joonastikkanen/esphome-nfc-components/hardware/vesimittari_v1_3/Havainne.FCStd

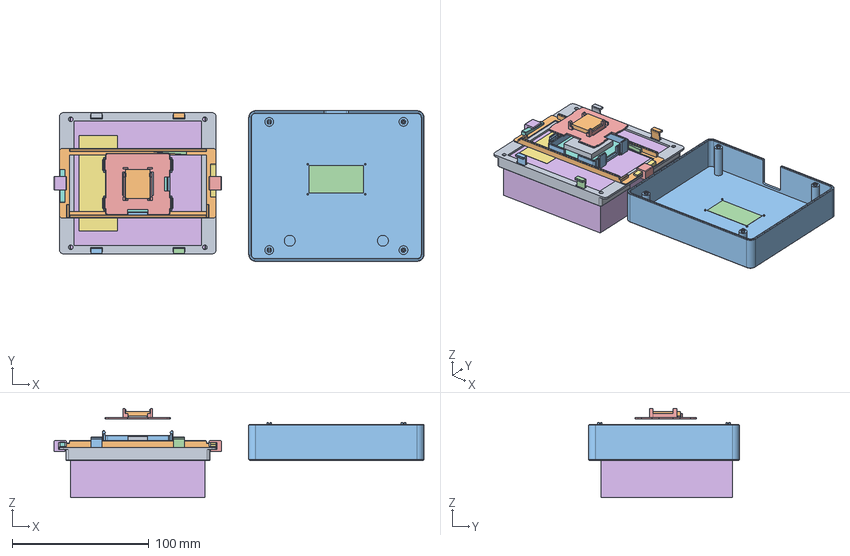
[picture p3: CAD file, 2026-11-05]
hardware/vesimittari_v1_3/Havainne.FCStd
270.2 x 110.0 x 65.0 mm
01 · Mittarin satula / sovitusrengas
02 · Y-liike ±16 mm / X-ohjain
03 · NFC-kortin liukukotelo / X ±20 mm
04 · X-säädön kitkakiila
05 · Y-säädön C-puristin, oikea
05b · Y-puristin, vasen
06 · Y-puristimen kiristyskiila, oikea
06b · Y-kiila, vasen
07 · Mittarikiinnityksen sovituskiila
072 · Sovituskiila
073 · Sovituskiila
074 · Sovituskiila
10 · NFC-kansi + ESP32-C3-pidike
Mittari 98 × 96 / näyttötaso +35 (yksinkertaistus)
Näyttö – sijainti vain havainnollinen
NFC PCB X42.6 × Y40.5 / paksuus oletus 1.6
NFC komponenttien tilavaraus, 6 mm oletus
ESP32-C3 17.8 × 21 × 3.5 – NFC-kannen päällä
Kansi_auki
WiFi_antenni
