joonastikkanen/esphome-nfc-components/hardware/vesimittari_v1_3/stl/01_Satula.stl

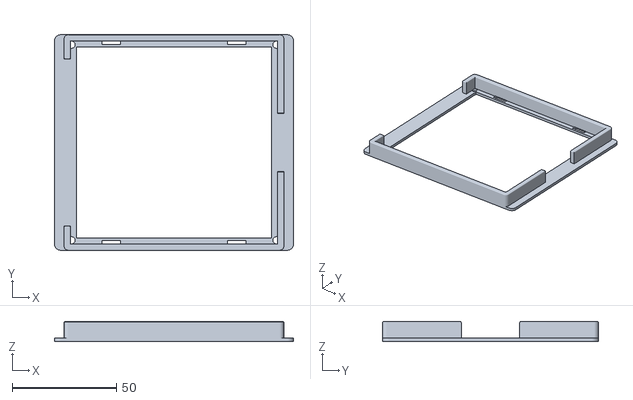
[picture p4: CAD file, 2026-11-05]
hardware/vesimittari_v1_3/stl/01_Satula.stl
114.4 x 103.2 x 9.60
