joonastikkanen/esphome-nfc-components/hardware/vesimittari_v1_3/stl/02_Poikittaiskelkka.stl

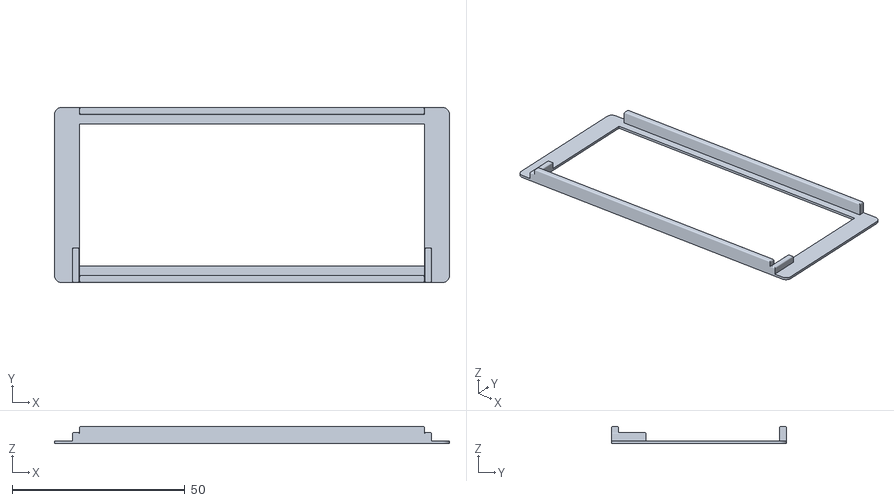
[picture p5: CAD file, 2026-11-05]
hardware/vesimittari_v1_3/stl/02_Poikittaiskelkka.stl
114.4 x 50.7 x 5.00
