joonastikkanen/esphome-nfc-components/hardware/vesimittari_v1_3/Vesimittari_NFC.step

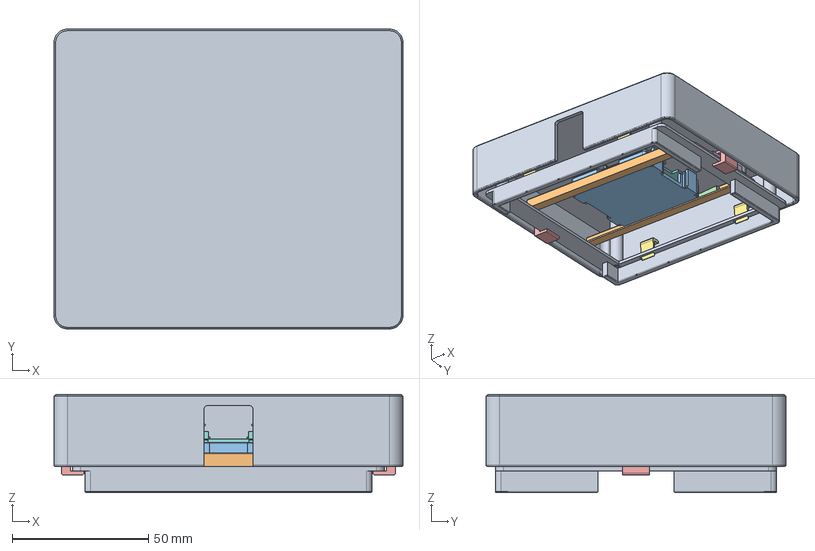
[picture p6: CAD file, 2026-11-05]
hardware/vesimittari_v1_3/Vesimittari_NFC.step
128.0 x 110.0 x 36.0 mm
