joonastikkanen/esphome-nfc-components/hardware/vesimittari_v1_3/stl/05_C_puristin.stl

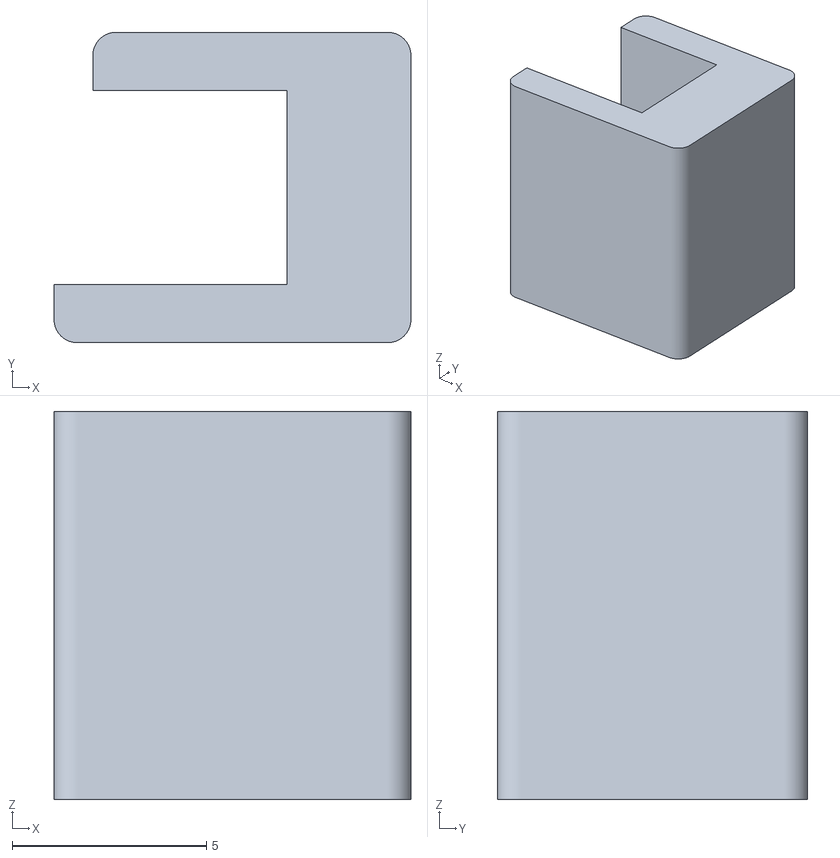
[picture p7: CAD file, 2026-11-05]
hardware/vesimittari_v1_3/stl/05_C_puristin.stl
9.20 x 8.00 x 10.0
