joonastikkanen/esphome-nfc-components/hardware/vesimittari_v1_3/Tulostusosat.FCStd

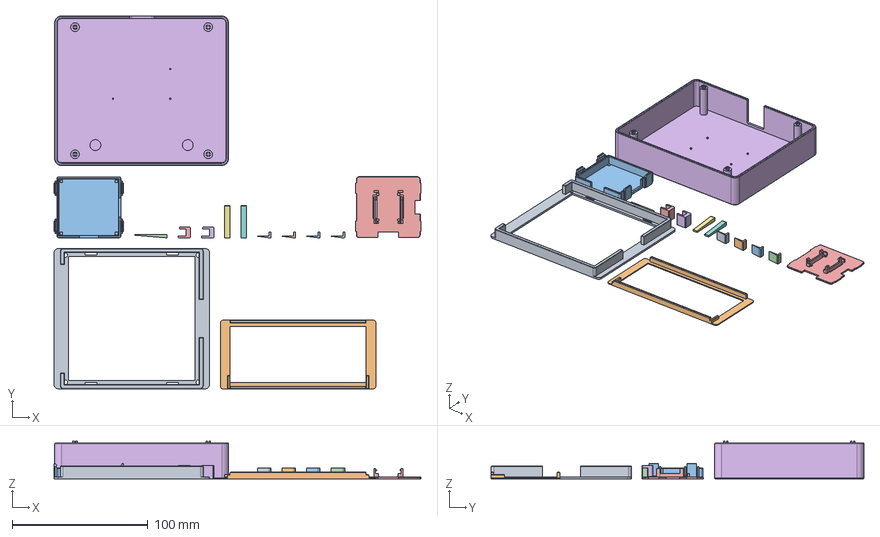
[picture p8: CAD file, 2026-11-05]
hardware/vesimittari_v1_3/Tulostusosat.FCStd
270.0 x 274.5 x 27.9 mm
01 · Mittarin satula / sovitusrengas / 1
02 · Y-liike ±16 mm / X-ohjain / 1
03 · NFC-kortin liukukotelo / X ±20 mm / 1
04 · X-säädön kitkakiila / 1
05 · Y-säädön C-puristin, oikea / 1
05 · Y-säädön C-puristin, oikea / 2
06 · Y-puristimen kiristyskiila, oikea / 1
06 · Y-puristimen kiristyskiila, oikea / 2
07 · Mittarikiinnityksen sovituskiila / 1
07 · Mittarikiinnityksen sovituskiila / 2
07 · Mittarikiinnityksen sovituskiila / 3
07 · Mittarikiinnityksen sovituskiila / 4
10 · NFC-kansi + ESP32-C3-pidike / 1
08 · Suojakansi / Wi-Fi-antenni / 1
