joonastikkanen/esphome-nfc-components/hardware/vesimittari_v1_3/stl/06_Y_kiila.stl

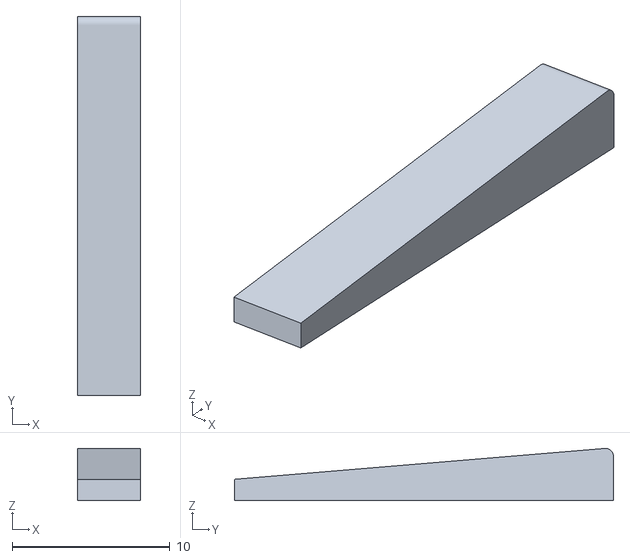
[picture p9: CAD file, 2026-11-05]
hardware/vesimittari_v1_3/stl/06_Y_kiila.stl
4.00 x 24.0 x 3.31
