joonastikkanen/esphome-nfc-components/hardware/vesimittari_v1_3/stl/03_NFC_kelkka.stl

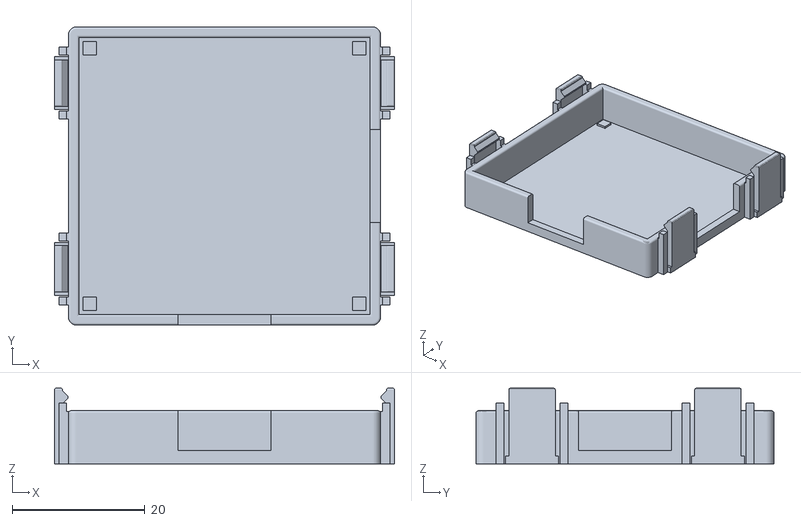
[picture p10: CAD file, 2026-11-05]
hardware/vesimittari_v1_3/stl/03_NFC_kelkka.stl
51.2 x 44.9 x 11.4
