joonastikkanen/esphome-nfc-components/hardware/vesimittari_v1_3/stl/08_Kansi.stl

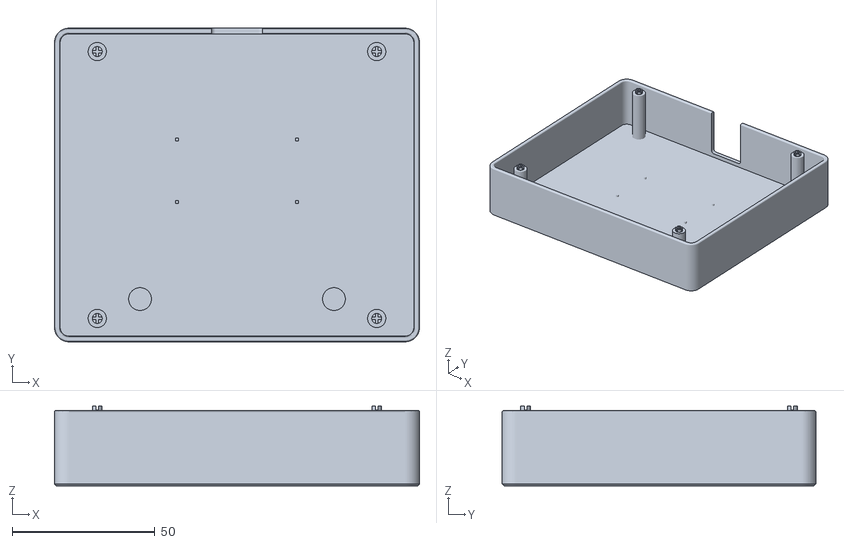
[picture p11: CAD file, 2026-11-05]
hardware/vesimittari_v1_3/stl/08_Kansi.stl
128.0 x 110.0 x 27.9
