joonastikkanen/esphome-nfc-components/hardware/vesimittari_v1_3/stl/04_X_kiila.stl

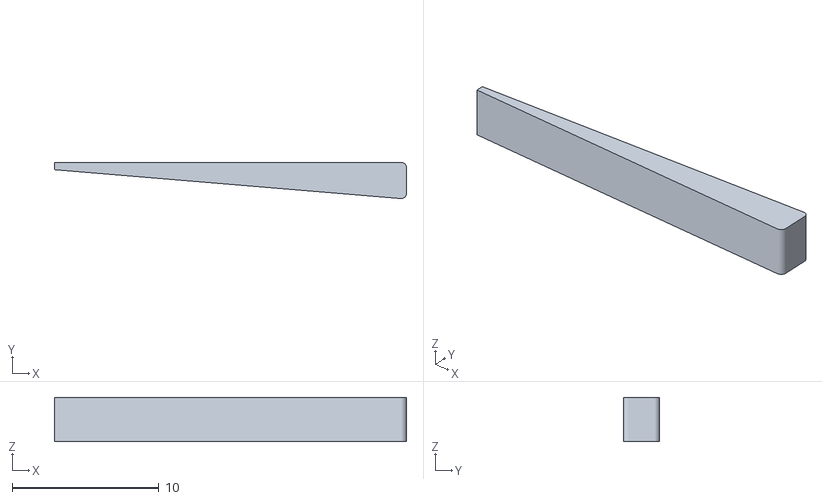
[picture p12: CAD file, 2026-11-05]
hardware/vesimittari_v1_3/stl/04_X_kiila.stl
24.0 x 2.47 x 3.00
