joonastikkanen/esphome-nfc-components/hardware/vesimittari_v1_3/stl/10_NFC_kansi_ESP_pidike.stl

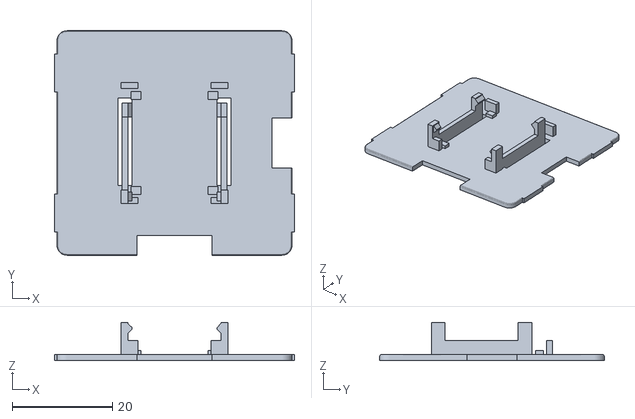
[picture p13: CAD file, 2026-11-05]
hardware/vesimittari_v1_3/stl/10_NFC_kansi_ESP_pidike.stl
48.0 x 44.9 x 7.60
