joonastikkanen/esphome-nfc-components/hardware/vesimittari_v1_3/stl/07_Sovituskiila.stl

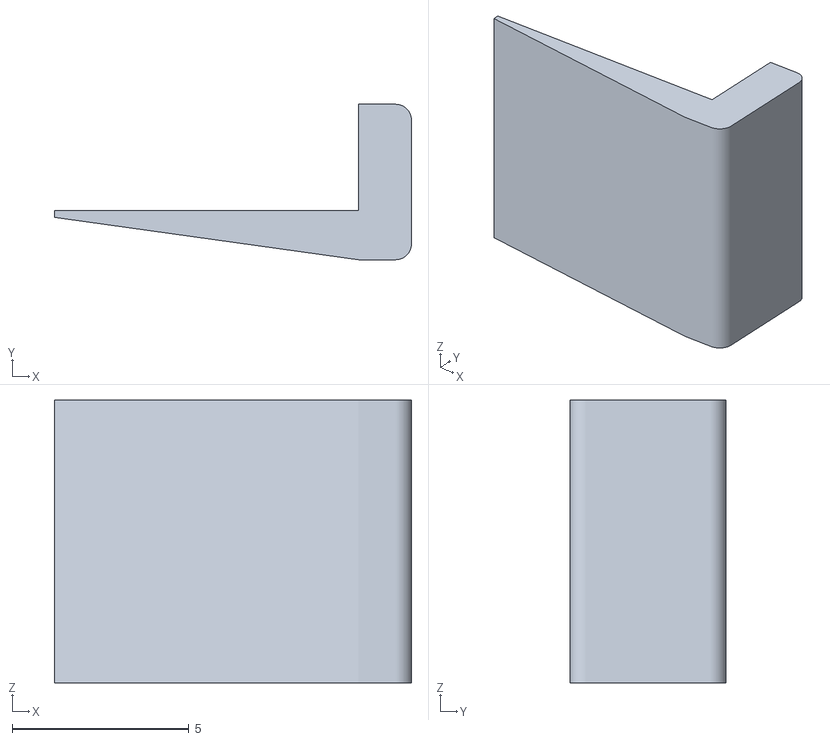
[picture p14: CAD file, 2026-11-05]
hardware/vesimittari_v1_3/stl/07_Sovituskiila.stl
10.1 x 4.40 x 8.00
