joonastikkanen/esphome-nfc-components/(list of files, cad)

Other CAD files:
hardware/vesimittari_v1_3/Vesimittari_NFC.FCStd
