joonastikkanen/esphome-nfc-components/(commit log)

2026-11-04 Expose native ESPHome meter sensors and configurable NFC read interval
2026-11-05 Add v1.3 enclosure CAD assets and English assembly guide
2026-11-11 Enhance PN532 NFC Reader with configurable response timeout and health diagnostics
    - Added `response_timeout` option to configure the timeout for NFC reads.
    - Introduced `ReaderHealth` class to track scan failures, recovery attempts, and reading age.
    - Updated `setup` and `loop` methods to handle initialization and recovery logic.
    - Added diagnostic sensors for NFC reading age, consecutive scan failures, and recovery attempts.
    - Implemented tests for the PN532 state machine and health tracking functionality.
